Semitia/M-P-Innovative-training/图片与视频/Untitled.png

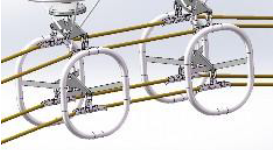
图片与视频/Untitled.png
