Semitia/M-P-Innovative-training/图片与视频/总体预览.png

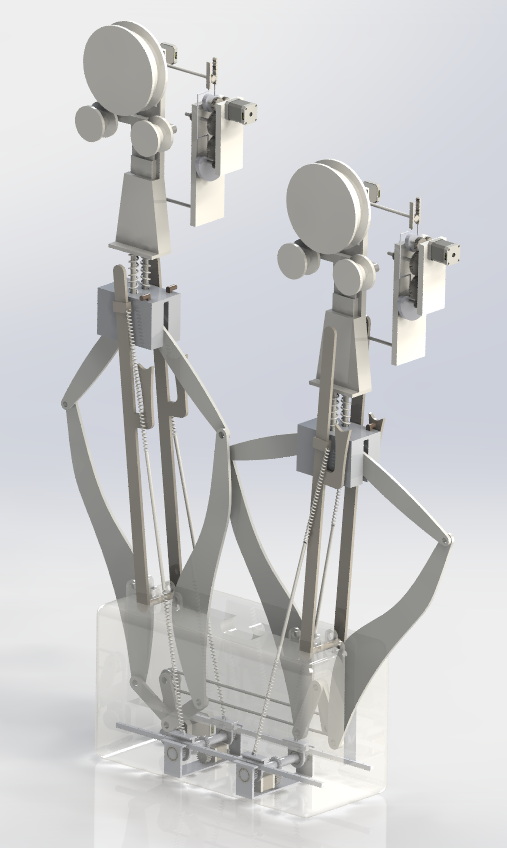
图片与视频/总体预览.png
