Semitia/M-P-Innovative-training/README.md

# M-P-Innovative-training
Innovative training in mechanical principles——机械原理创新训练课程设计
