Semitia/M-P-Innovative-training/图片与视频/Untitled 6.png

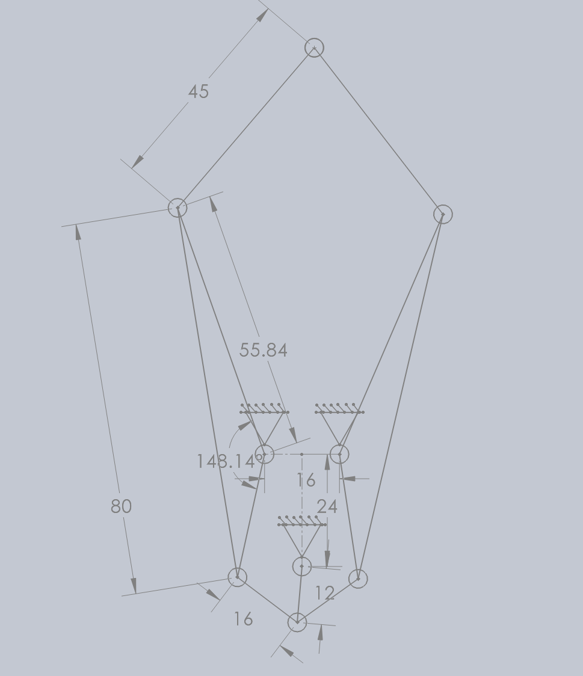
图片与视频/Untitled 6.png
