Semitia/M-P-Innovative-training/图片与视频/Untitled 24.png

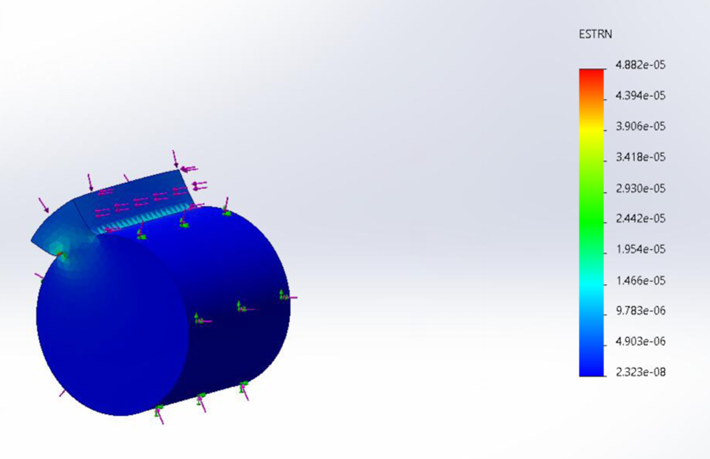
图片与视频/Untitled 24.png
