Semitia/M-P-Innovative-training/图片与视频/Untitled 32.png

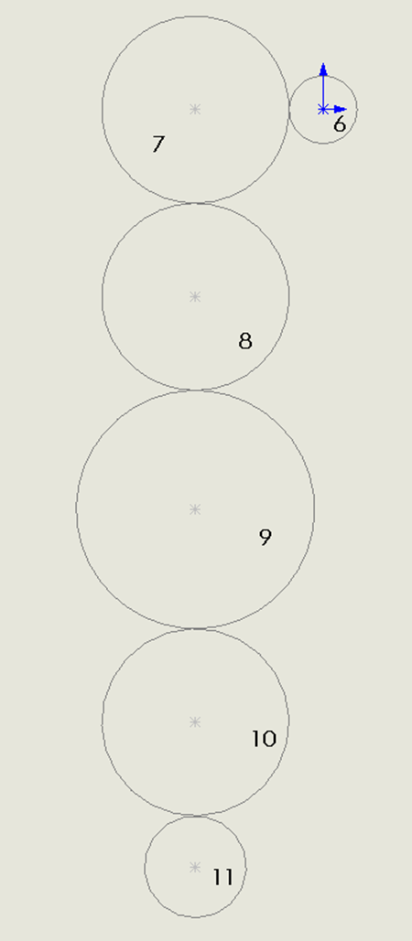
图片与视频/Untitled 32.png
