Semitia/M-P-Innovative-training/结构模型/凸轮齿轮齿条机构.SLDASM

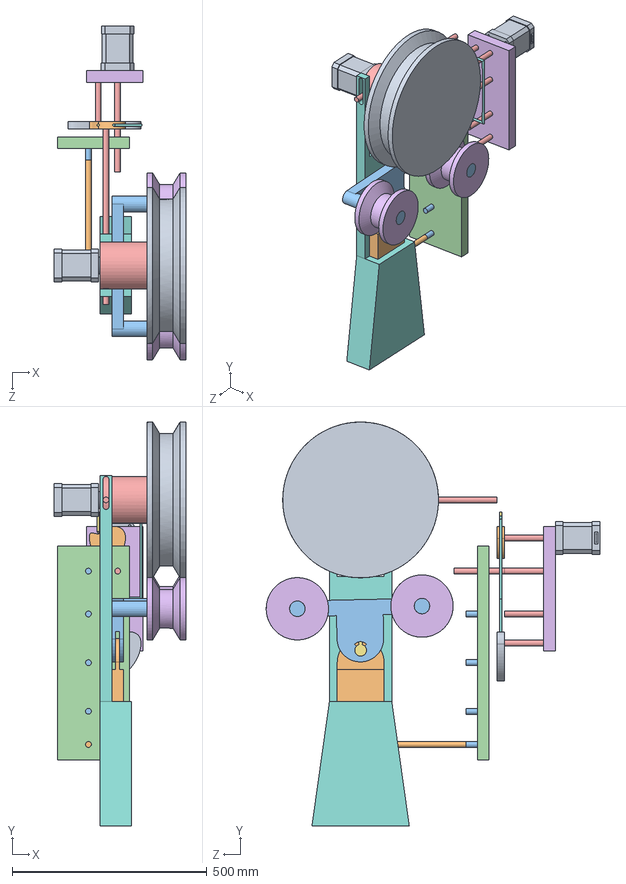
[picture p60: CAD file, 2023-04-17]
结构模型/凸轮齿轮齿条机构.SLDASM
338.0 x 1037.1 x 856.4 mm
左轮试验
右轮试验
推杆2
推杆
齿轮系底座
齿轮轴 x 6
4个弹簧
T上
T下
大轮
底座
销钉
小轮 x 2
ZHOU
齿轮系底座2
齿轮轴2 x 5
齿轮轴3
42步进电机 x 2
