Semitia/M-P-Innovative-training/结构模型/装机.SLDASM

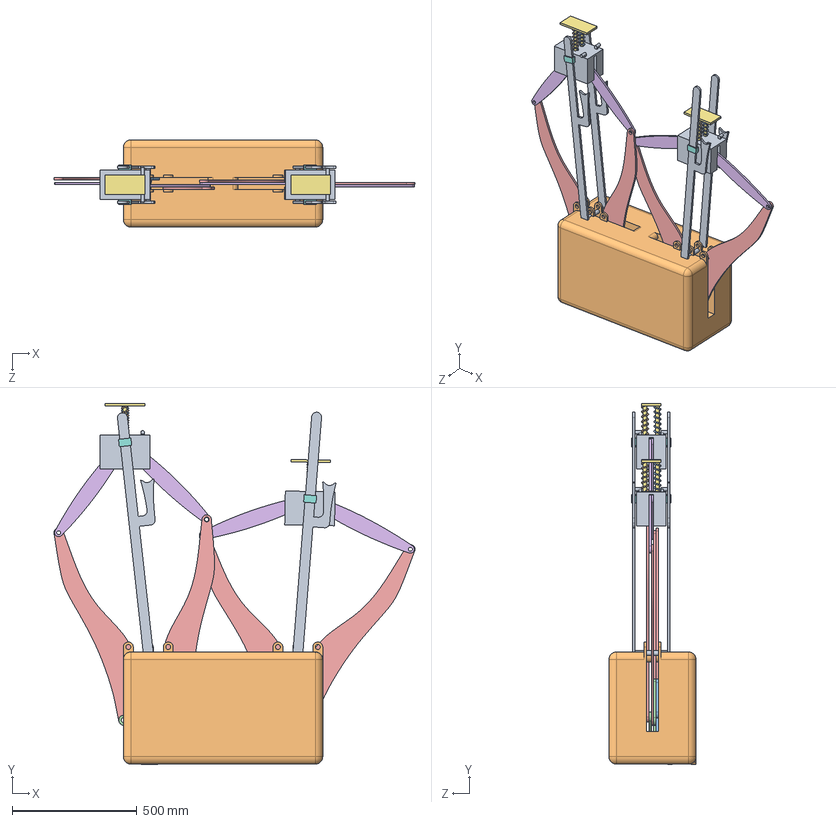
[picture p61: CAD file, 2023-04-17]
结构模型/装机.SLDASM
1448.2 x 1450.0 x 350.0 mm
机架
120mm连杆 x 2
160mm连杆(12) x 4
三角板mini x 4
450mm连杆(45)（内） x 4
升降台 x 2
脚踝 x 4
提轴 x 4
挂箱 x 2
弹簧^脚踝 x 2
弹簧2^脚踝 x 2
小弹簧^脚踝 x 2
小弹簧2^脚踝 x 2
皮带轮 x 3
皮带^装机
滑块 x 4
提杆 x 2
42步进电机
皮带2^装机
