Semitia/M-P-Innovative-training/结构模型/改版平衡机构.SLDASM

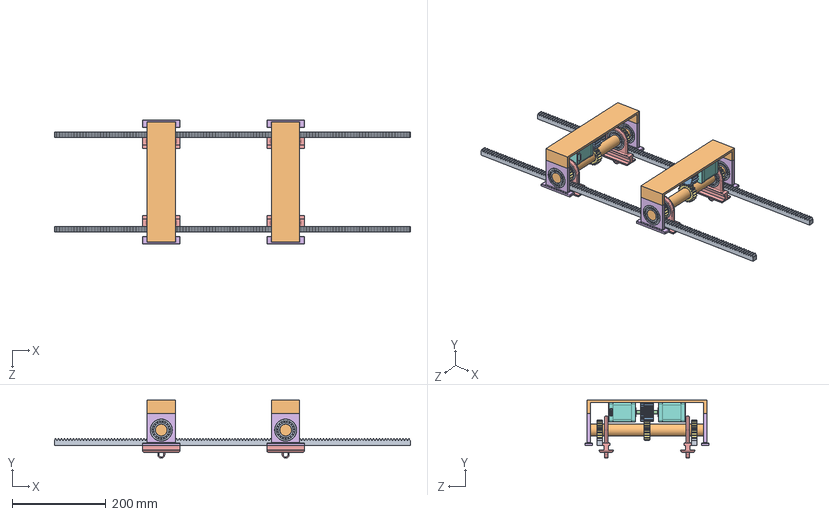
[picture p62: CAD file, 2023-04-17]
结构模型/改版平衡机构.SLDASM
760.0 x 123.5 x 265.0 mm
齿条88 x 2
轴 x 2
VNA22-2-0-18-B20-P8-V0 x 2
过度零件 x 2
轴承座2 x 4
轴承座3 x 4
圆柱齿轮20×2 x 6
42步进电机轴双出轴 x 2
deep groove ball bearings gb x 8
底板2 x 2
胖键 x 6
