Semitia/M-P-Innovative-training/结构模型/平衡加行走.SLDASM

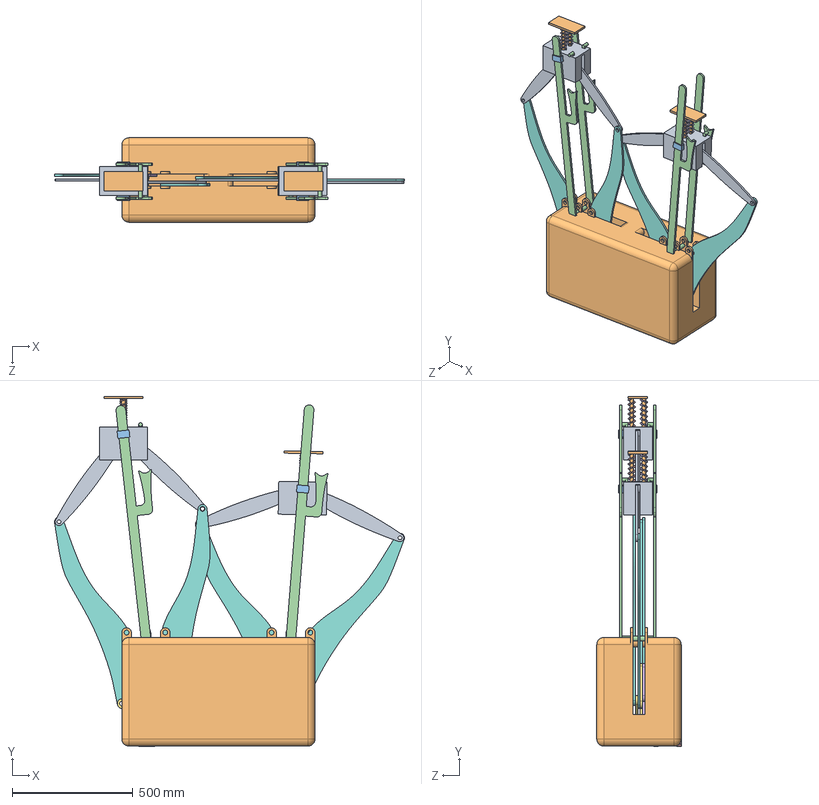
[picture p63: CAD file, 2023-04-17]
结构模型/平衡加行走.SLDASM
1448.2 x 1450.0 x 350.0 mm
齿条88 x 2
轴 x 2
VNA22-2-0-18-B20-P8-V0 x 2
过度零件 x 2
轴承座2 x 4
轴承座3 x 4
圆柱齿轮20×2 x 6
42步进电机轴双出轴 x 2
deep groove ball bearings gb x 8
底板2 x 2
胖键 x 6
机架
120mm连杆 x 2
160mm连杆(12) x 4
三角板mini x 4
450mm连杆(45)（内） x 4
升降台 x 2
脚踝 x 4
提轴 x 4
挂箱 x 2
弹簧^脚踝 x 2
弹簧2^脚踝 x 2
小弹簧^脚踝 x 2
小弹簧2^脚踝 x 2
皮带轮 x 3
皮带^装机
滑块 x 4
提杆 x 2
42步进电机
皮带2^装机
