Semitia/M-P-Innovative-training/结构模型/脚踝.SLDASM

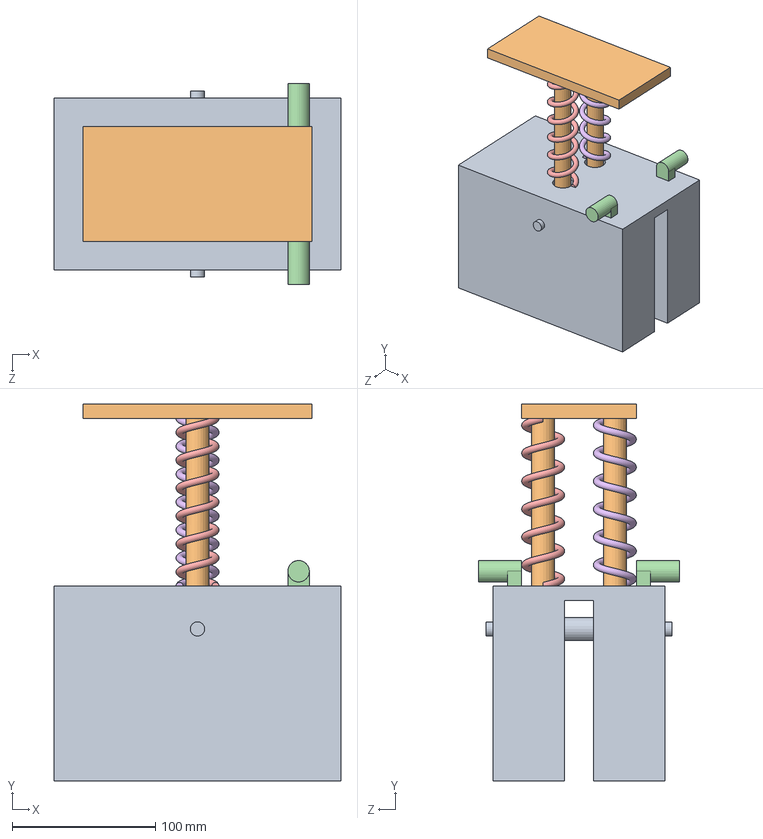
[picture p64: CAD file, 2023-04-17]
结构模型/脚踝.SLDASM
200.0 x 262.9 x 140.0 mm
升降台
脚踝 x 2
提轴 x 2
挂箱
弹簧^脚踝
弹簧2^脚踝
小弹簧^脚踝
小弹簧2^脚踝
