Semitia/M-P-Innovative-training/结构模型/滑块.SLDPRT

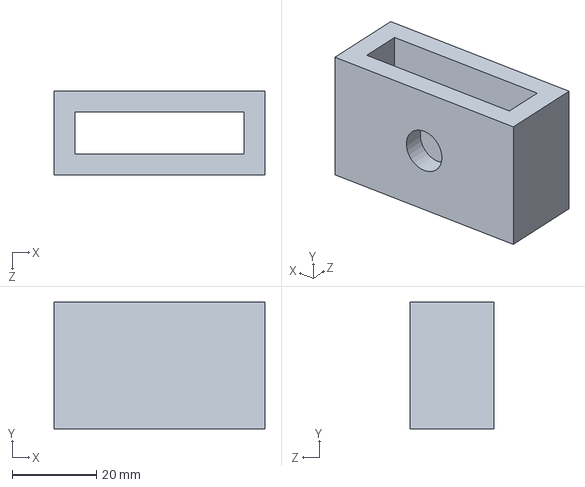
[picture p65: CAD file, 2023-04-17]
结构模型/滑块.SLDPRT
50.0 x 30.0 x 20.0 mm
