Semitia/M-P-Innovative-training/结构模型/底板2.SLDPRT

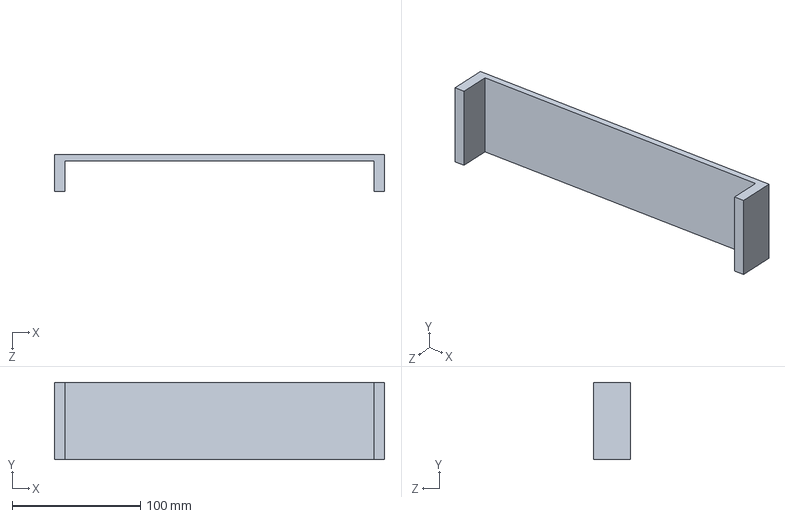
[picture p66: CAD file, 2023-04-17]
结构模型/底板2.SLDPRT
257.0 x 60.0 x 29.0 mm
