Semitia/M-P-Innovative-training/结构模型/42步进电机.SLDPRT

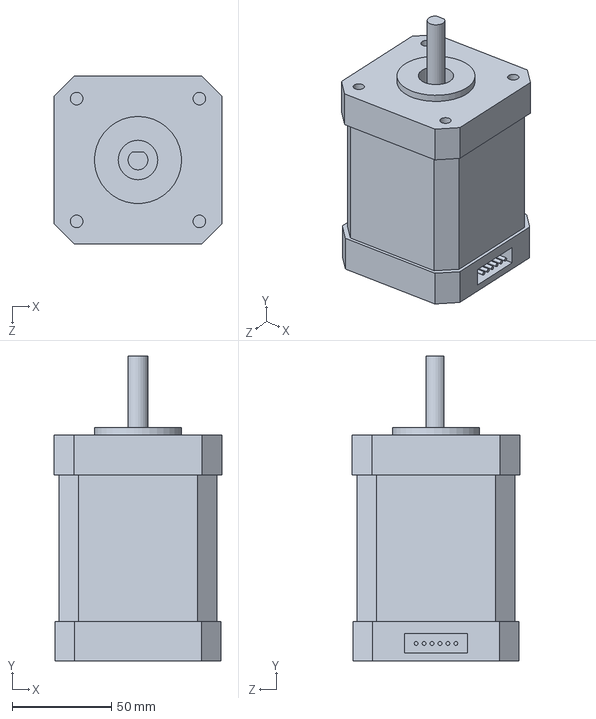
[picture p67: CAD file, 2023-04-17]
结构模型/42步进电机.SLDPRT
84.6 x 154.0 x 84.6 mm
