Semitia/M-P-Innovative-training/结构模型/圆柱齿轮20×2.SLDPRT

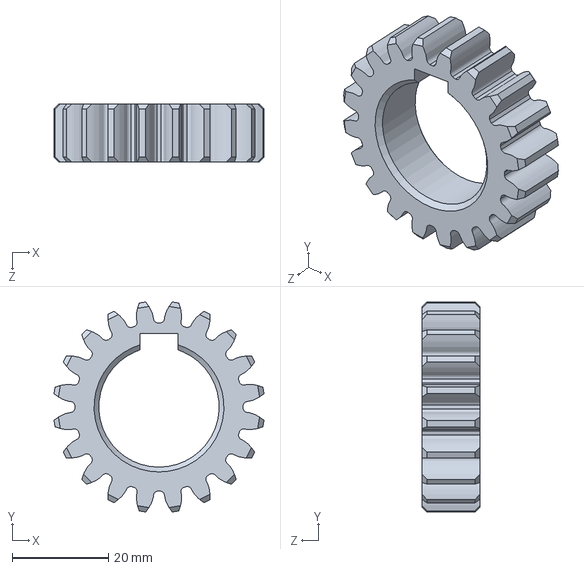
[picture p68: CAD file, 2023-04-17]
结构模型/圆柱齿轮20×2.SLDPRT
43.7 x 43.7 x 12.0 mm
