Semitia/M-P-Innovative-training/结构模型/推杆.SLDPRT

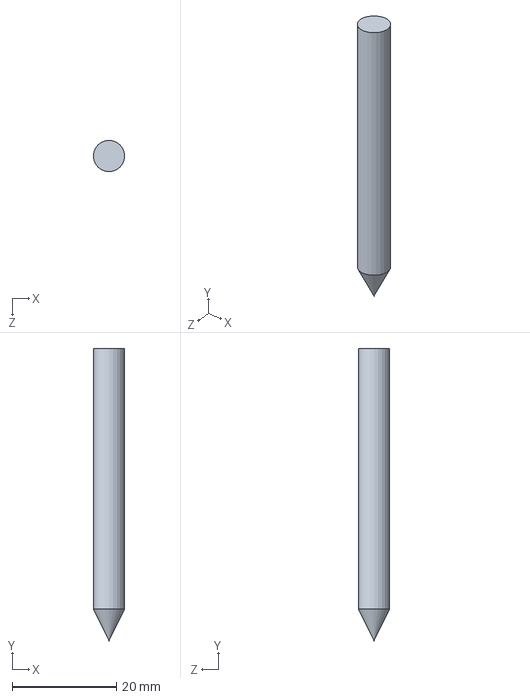
[picture p69: CAD file, 2023-04-17]
结构模型/推杆.SLDPRT
6.00 x 56.0 x 6.00 mm
