Semitia/M-P-Innovative-training/结构模型/齿轮系底座.SLDPRT

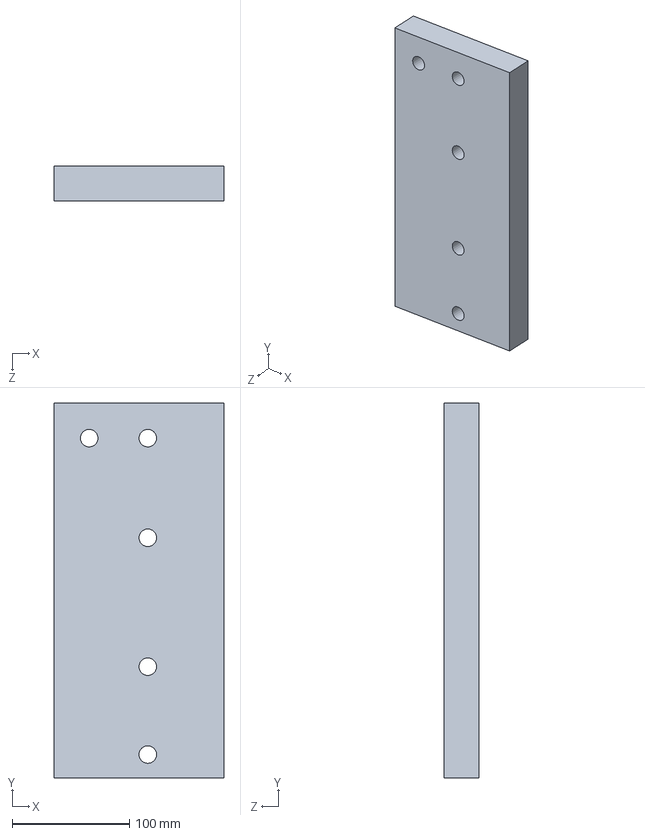
[picture p70: CAD file, 2023-04-17]
结构模型/齿轮系底座.SLDPRT
145.0 x 320.0 x 30.0 mm
