Semitia/M-P-Innovative-training/结构模型/轴承座3.SLDPRT

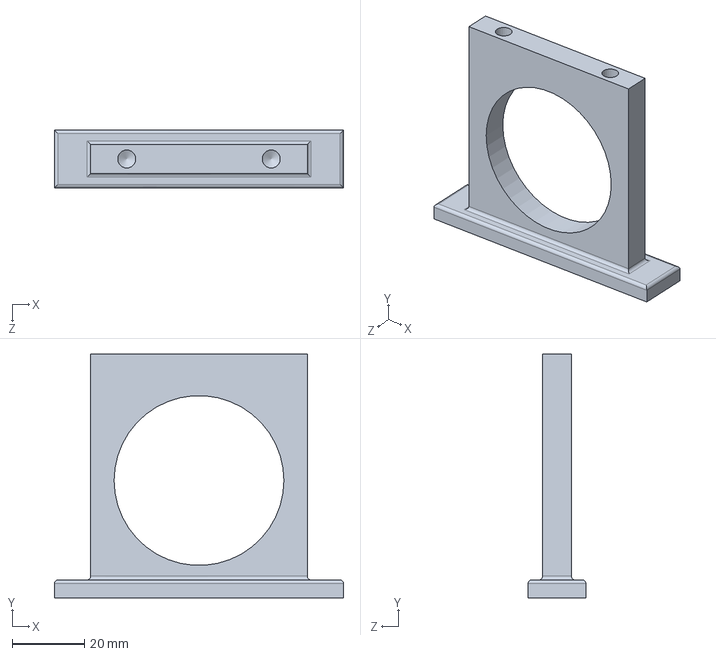
[picture p71: CAD file, 2023-04-17]
结构模型/轴承座3.SLDPRT
80.0 x 67.5 x 16.0 mm
