Semitia/M-P-Innovative-training/结构模型/三角板mini.SLDPRT

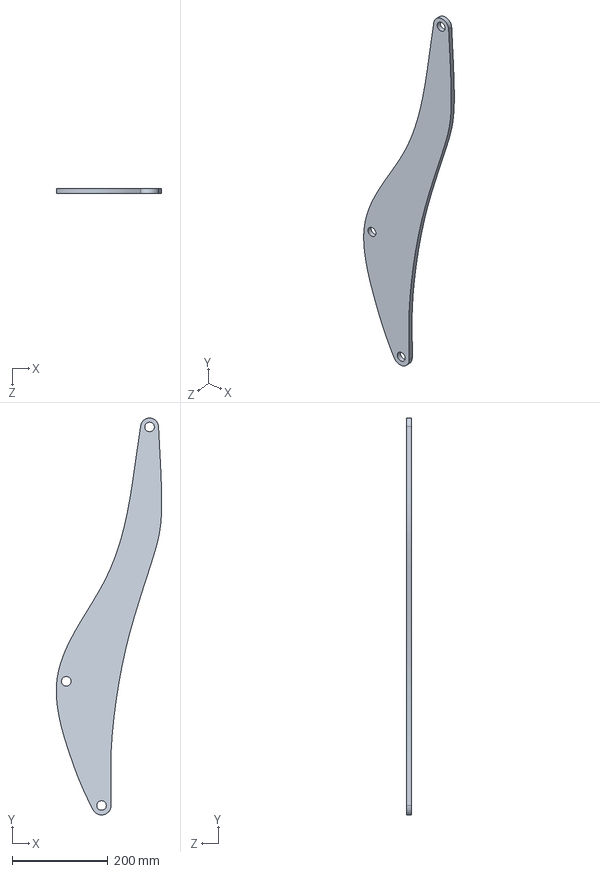
[picture p72: CAD file, 2023-04-17]
结构模型/三角板mini.SLDPRT
220.0 x 828.4 x 10.0 mm
