Semitia/M-P-Innovative-training/结构模型/T上.SLDPRT

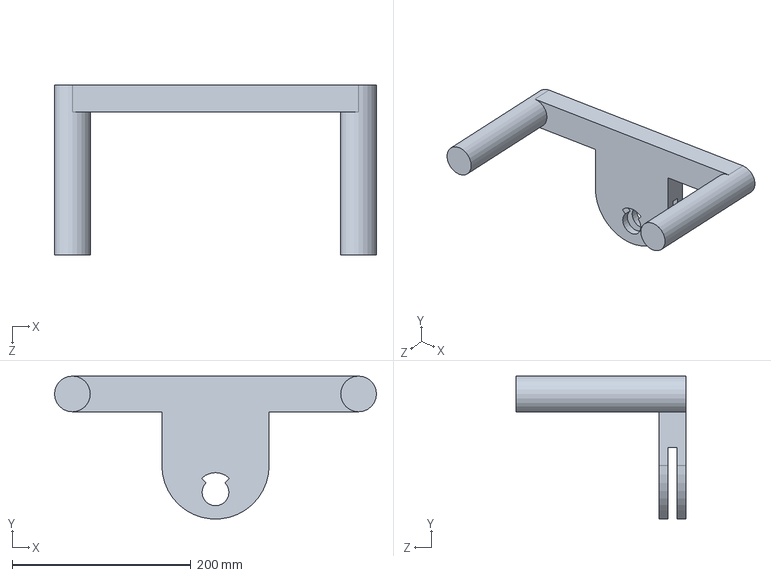
[picture p73: CAD file, 2023-04-17]
结构模型/T上.SLDPRT
360.0 x 159.8 x 190.0 mm
