Semitia/M-P-Innovative-training/结构模型/右轮试验.SLDPRT

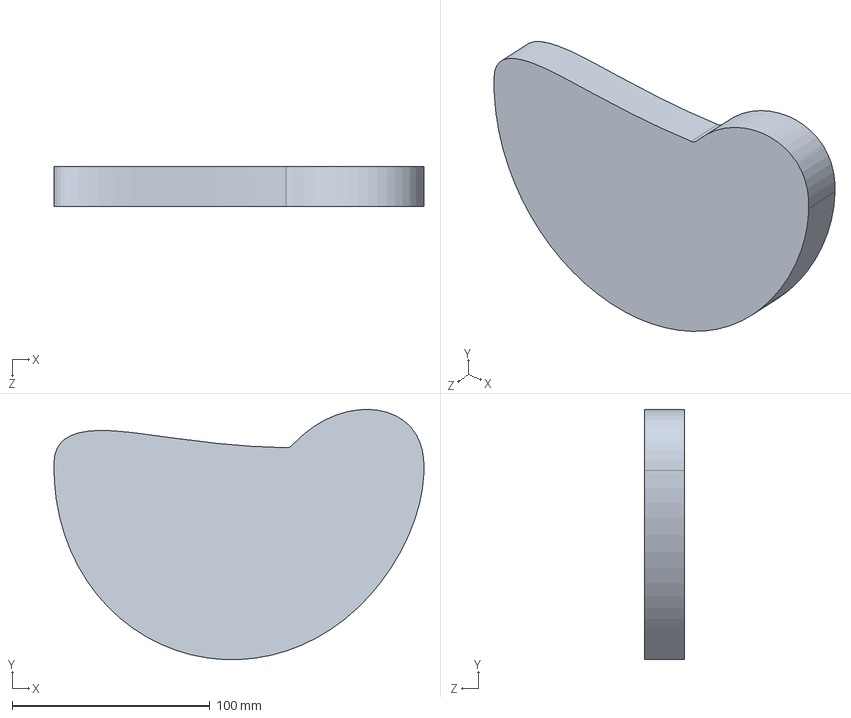
[picture p74: CAD file, 2023-04-17]
结构模型/右轮试验.SLDPRT
187.1 x 126.5 x 20.0 mm
