Semitia/M-P-Innovative-training/结构模型/42步进电机轴双出轴.SLDPRT

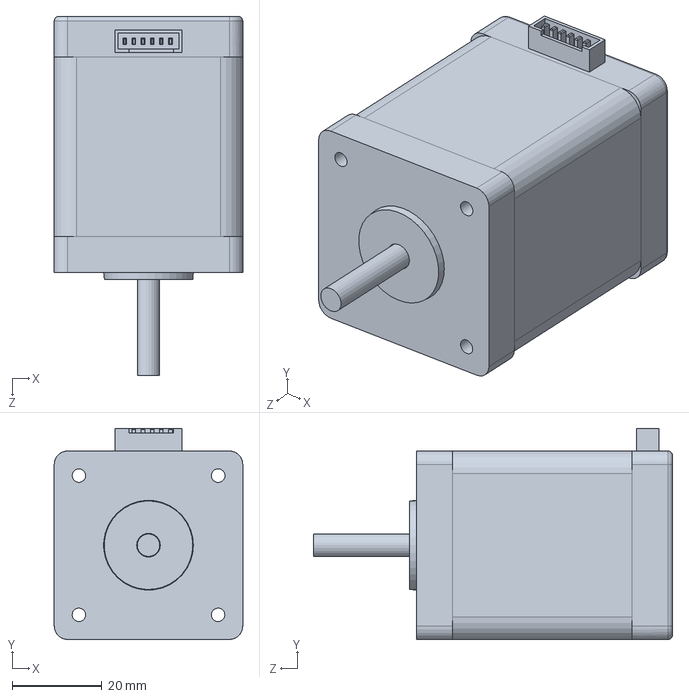
[picture p75: CAD file, 2023-04-17]
结构模型/42步进电机轴双出轴.SLDPRT
42.0 x 47.0 x 80.0 mm
