Semitia/M-P-Innovative-training/结构模型/ZHOU.SLDPRT

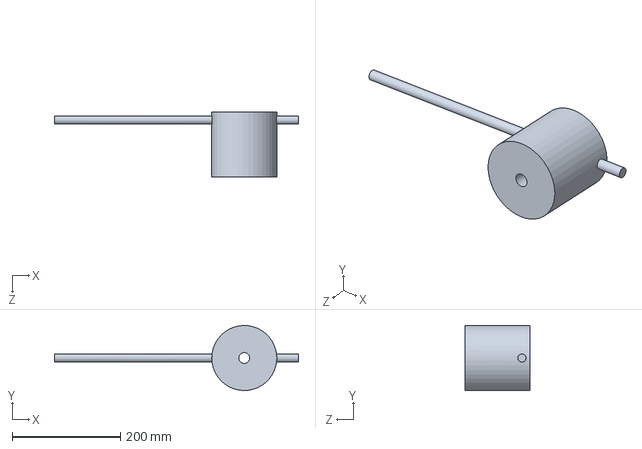
[picture p76: CAD file, 2023-04-17]
结构模型/ZHOU.SLDPRT
450.0 x 119.9 x 120.0 mm
