Semitia/M-P-Innovative-training/结构模型/左轮试验.SLDPRT

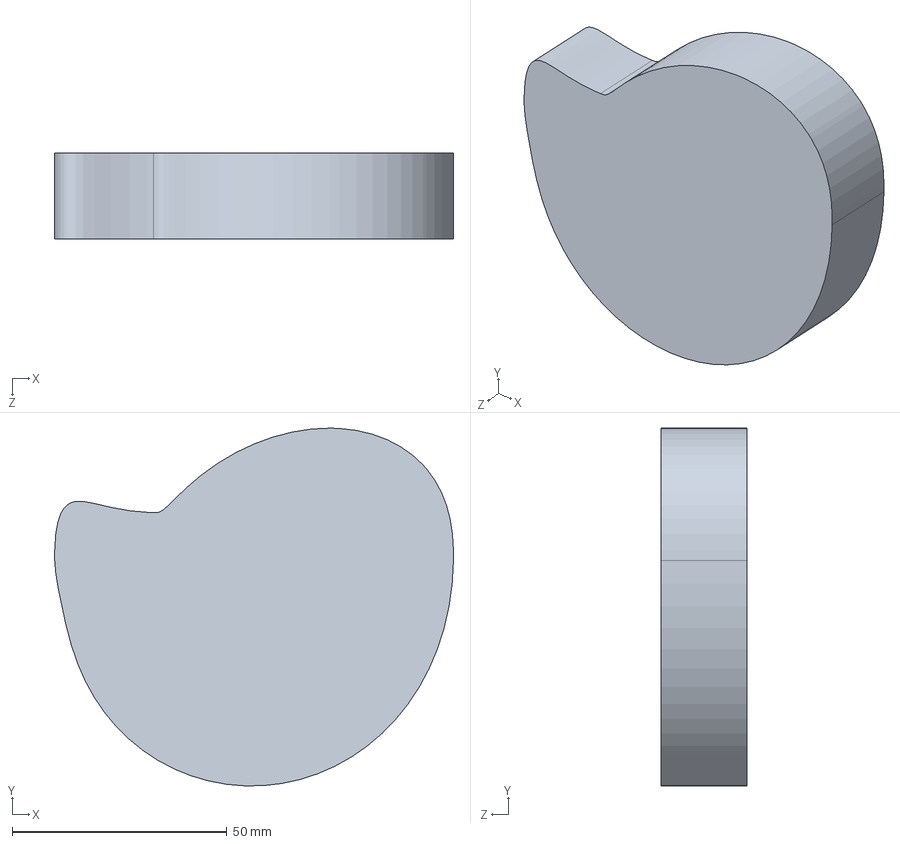
[picture p77: CAD file, 2023-04-17]
结构模型/左轮试验.SLDPRT
92.9 x 83.3 x 20.0 mm
