Semitia/M-P-Innovative-training/结构模型/机架.SLDPRT

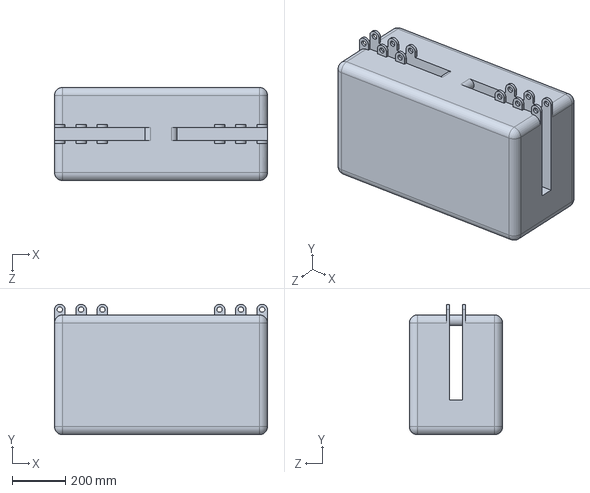
[picture p78: CAD file, 2023-04-17]
结构模型/机架.SLDPRT
800.0 x 490.0 x 350.0 mm
