Semitia/M-P-Innovative-training/结构模型/齿轮轴2.SLDPRT

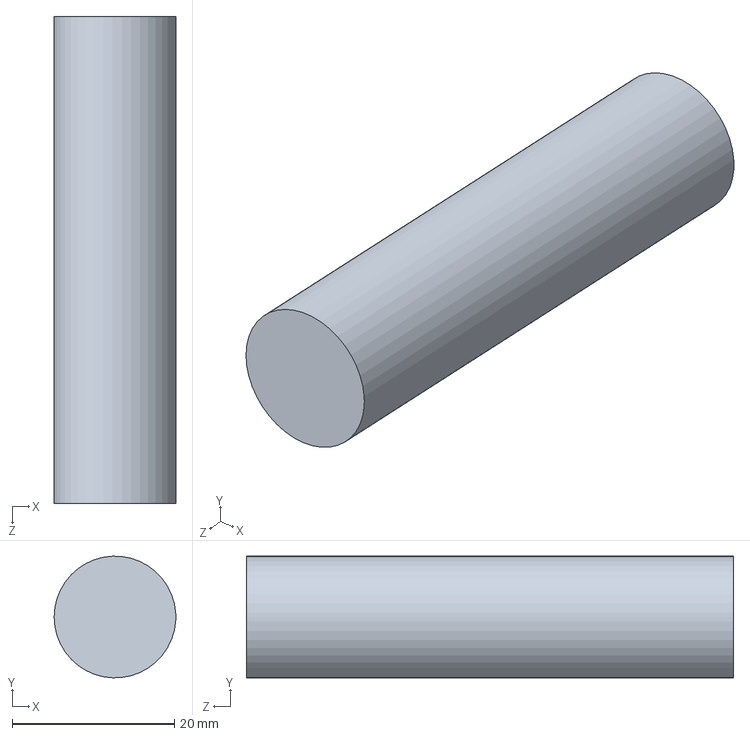
[picture p79: CAD file, 2023-04-17]
结构模型/齿轮轴2.SLDPRT
15.0 x 15.0 x 60.0 mm
