Semitia/M-P-Innovative-training/结构模型/轴.SLDPRT

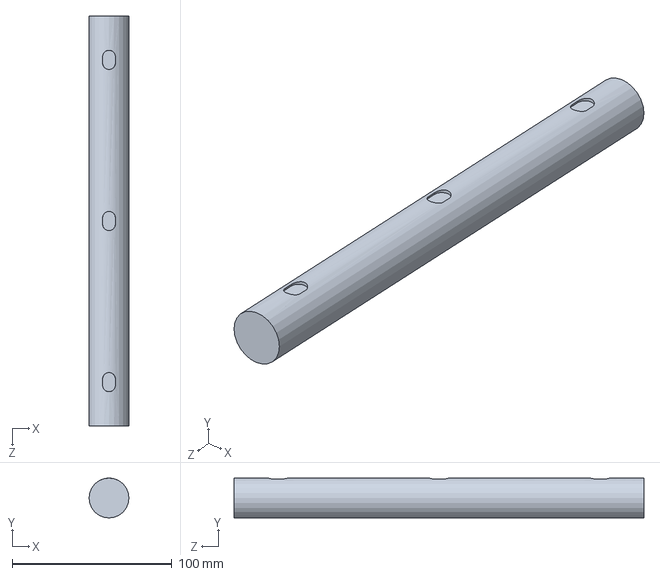
[picture p80: CAD file, 2023-04-17]
结构模型/轴.SLDPRT
25.0 x 25.0 x 257.0 mm
