Semitia/M-P-Innovative-training/结构模型/450mm连杆(45)（内）.SLDPRT

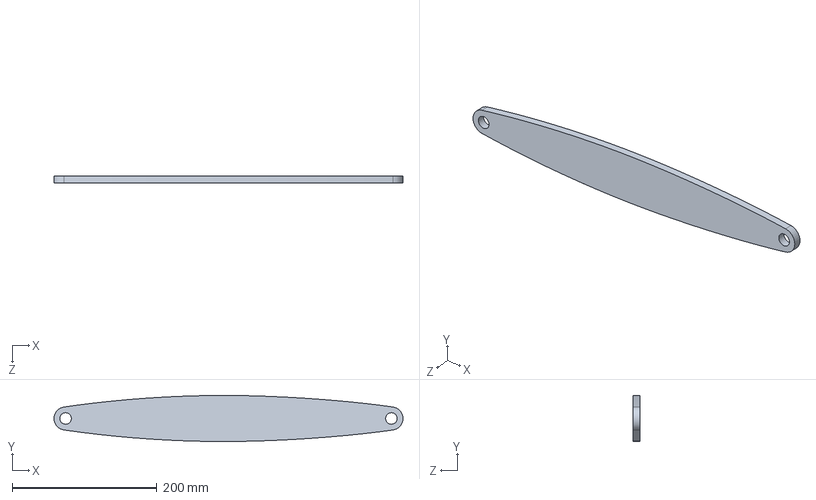
[picture p81: CAD file, 2023-04-17]
结构模型/450mm连杆(45)（内）.SLDPRT
482.0 x 63.6 x 10.0 mm
