Semitia/M-P-Innovative-training/结构模型/VNA22-2-0-18-B20-P8-V0.sldprt

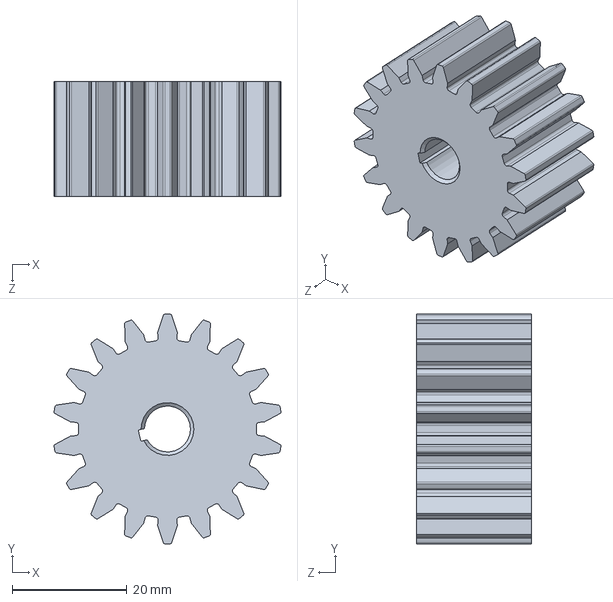
[picture p82: CAD file, 2023-04-17]
结构模型/VNA22-2-0-18-B20-P8-V0.sldprt
39.5 x 40.0 x 20.0 mm
