Semitia/M-P-Innovative-training/结构模型/胖键.SLDPRT

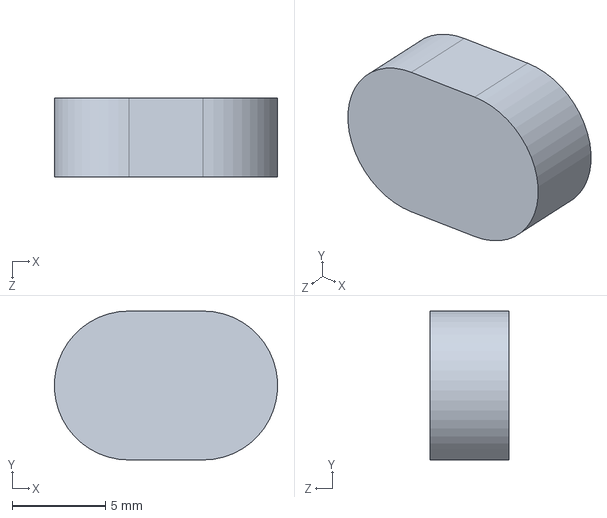
[picture p83: CAD file, 2023-04-17]
结构模型/胖键.SLDPRT
12.0 x 8.00 x 4.27 mm
