Semitia/M-P-Innovative-training/结构模型/小轮.SLDPRT

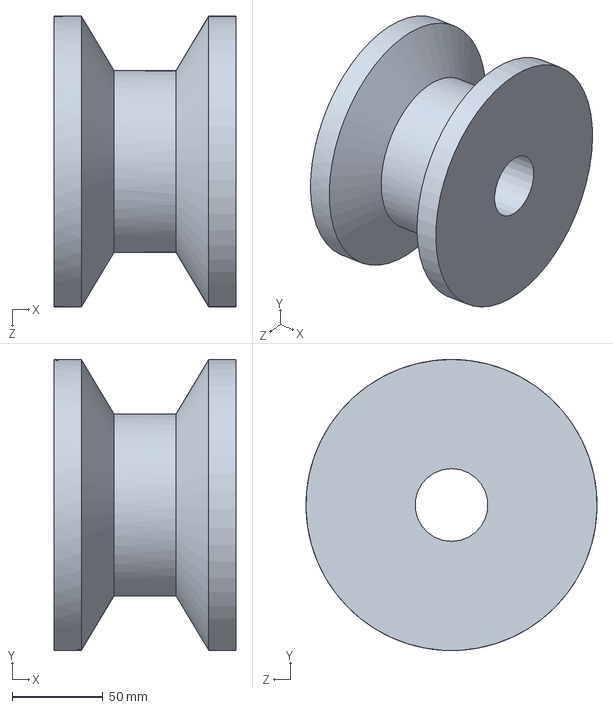
[picture p84: CAD file, 2023-04-17]
结构模型/小轮.SLDPRT
100.0 x 160.0 x 159.9 mm
