Semitia/M-P-Innovative-training/结构模型/挂箱.SLDPRT

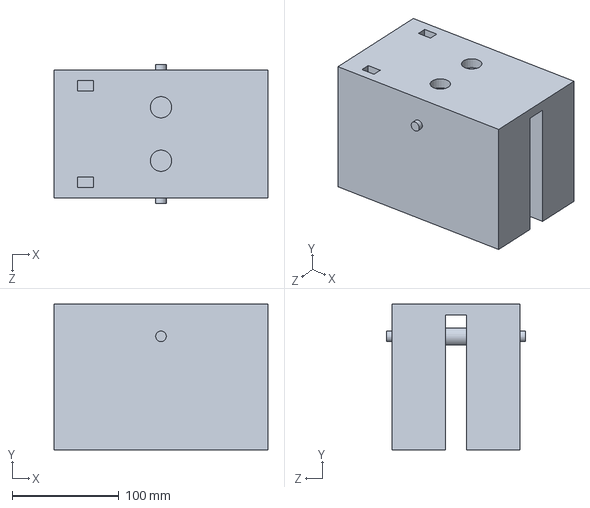
[picture p85: CAD file, 2023-04-17]
结构模型/挂箱.SLDPRT
200.0 x 136.0 x 130.0 mm
