Semitia/M-P-Innovative-training/结构模型/120mm连杆.SLDPRT

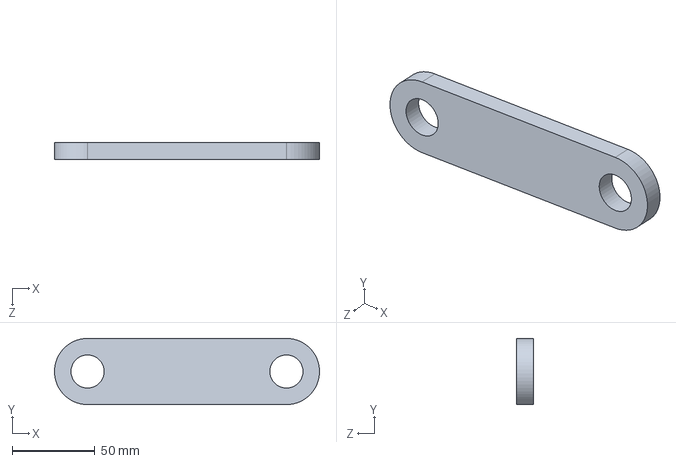
[picture p86: CAD file, 2023-04-17]
结构模型/120mm连杆.SLDPRT
159.9 x 40.0 x 10.0 mm
