Semitia/M-P-Innovative-training/结构模型/提杆.SLDPRT

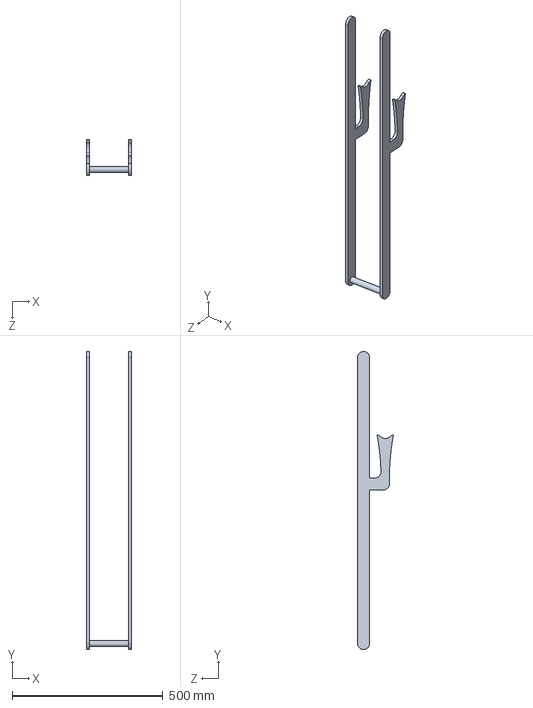
[picture p87: CAD file, 2023-04-17]
结构模型/提杆.SLDPRT
150.0 x 989.7 x 119.3 mm
