Semitia/M-P-Innovative-training/结构模型/T下.SLDPRT

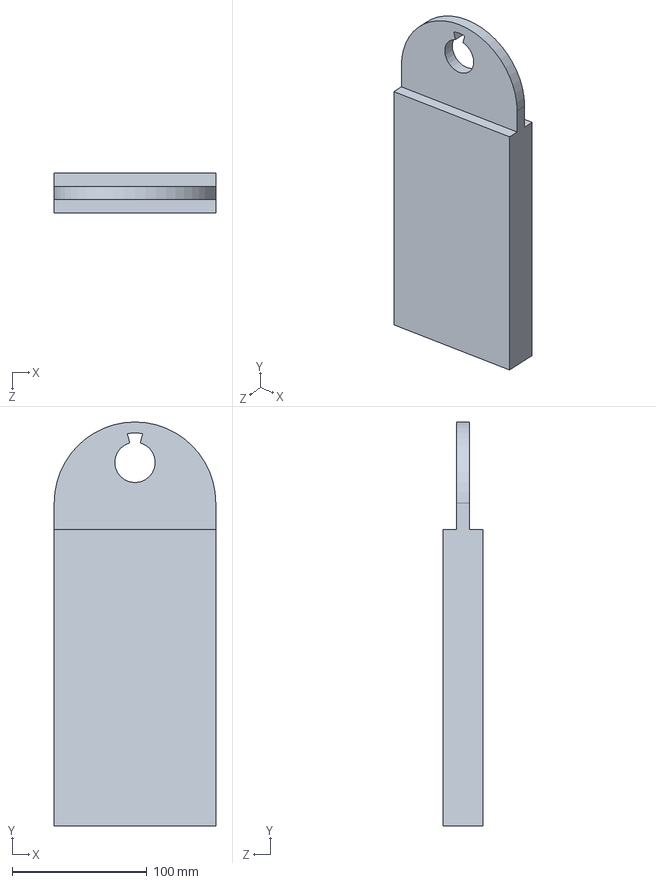
[picture p88: CAD file, 2023-04-17]
结构模型/T下.SLDPRT
120.0 x 300.0 x 30.0 mm
