Semitia/M-P-Innovative-training/结构模型/过度零件.SLDPRT

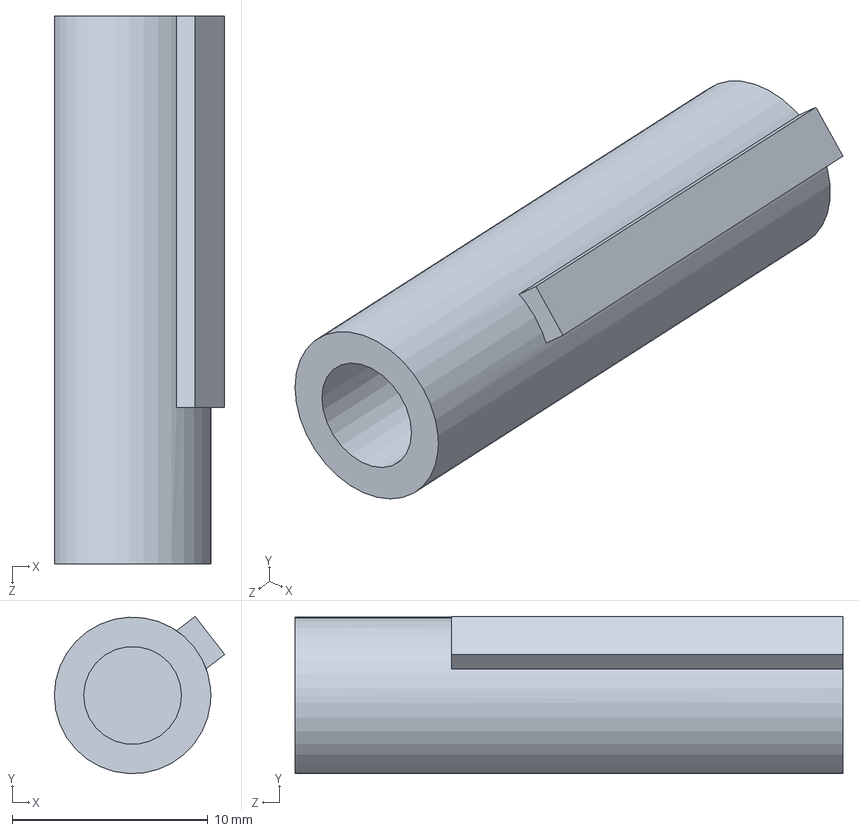
[picture p89: CAD file, 2023-04-17]
结构模型/过度零件.SLDPRT
8.71 x 8.03 x 28.0 mm
