Semitia/M-P-Innovative-training/结构模型/4个弹簧.SLDPRT

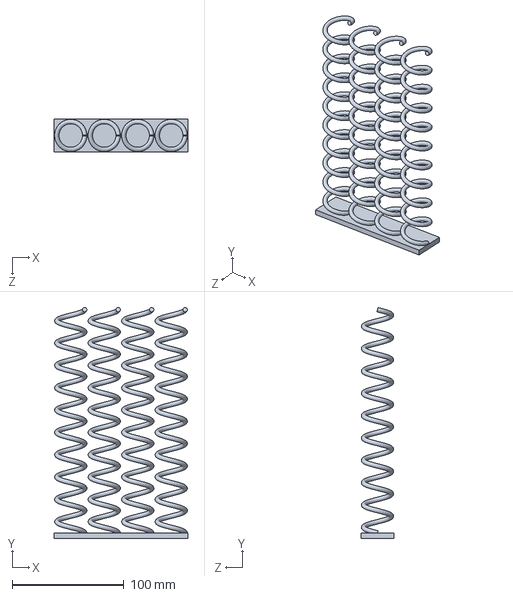
[picture p90: CAD file, 2023-04-17]
结构模型/4个弹簧.SLDPRT
120.0 x 206.9 x 30.0 mm
