Semitia/M-P-Innovative-training/结构模型/齿轮轴3.SLDPRT

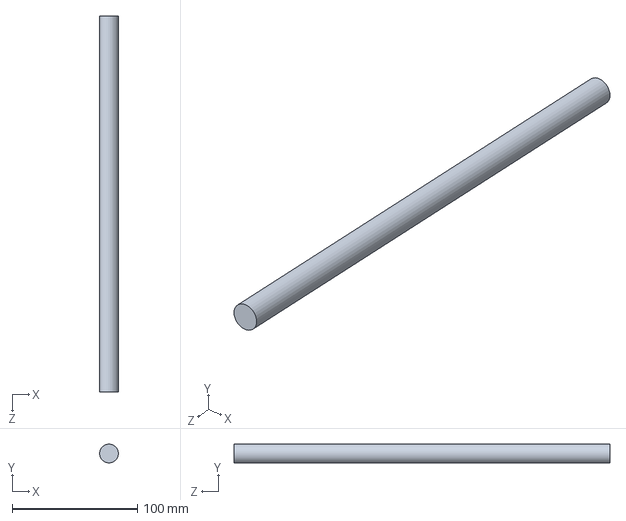
[picture p91: CAD file, 2023-04-17]
结构模型/齿轮轴3.SLDPRT
15.0 x 14.9 x 300.0 mm
