Semitia/M-P-Innovative-training/结构模型/轴承座2.SLDPRT

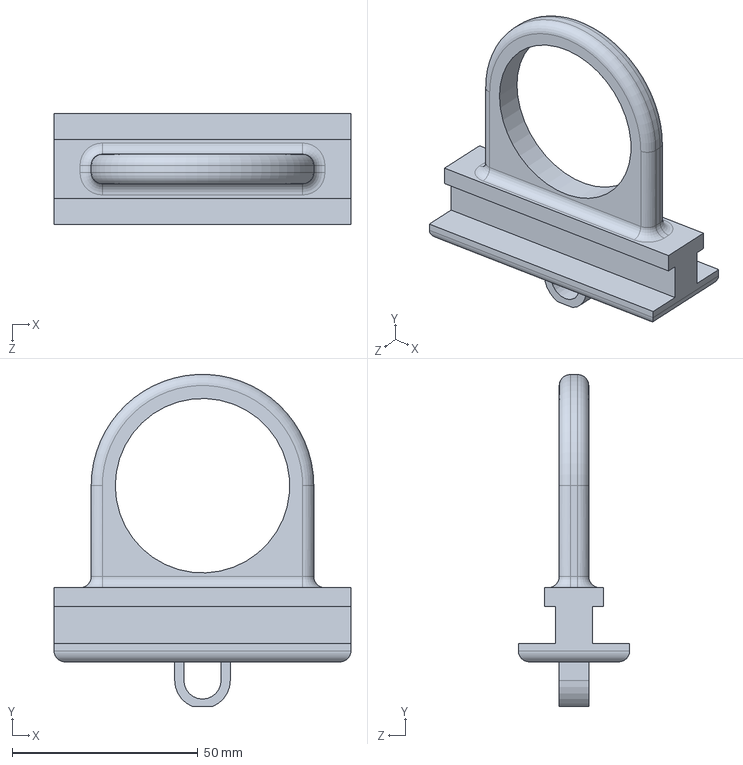
[picture p92: CAD file, 2023-04-17]
结构模型/轴承座2.SLDPRT
80.0 x 89.5 x 30.0 mm
