Semitia/M-P-Innovative-training/结构模型/升降台.SLDPRT

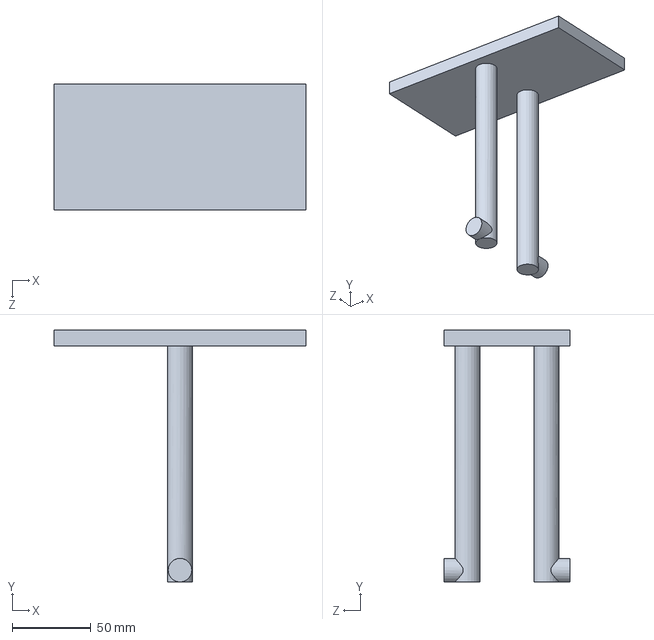
[picture p93: CAD file, 2023-04-17]
结构模型/升降台.SLDPRT
160.0 x 160.0 x 80.0 mm
