Semitia/M-P-Innovative-training/结构模型/销钉.SLDPRT

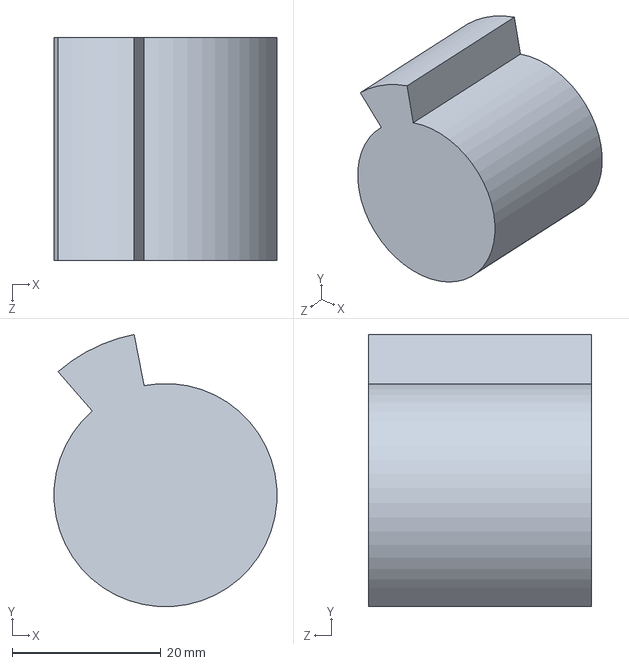
[picture p94: CAD file, 2023-04-17]
结构模型/销钉.SLDPRT
29.9 x 36.6 x 30.0 mm
