Semitia/M-P-Innovative-training/结构模型/提轴.SLDPRT

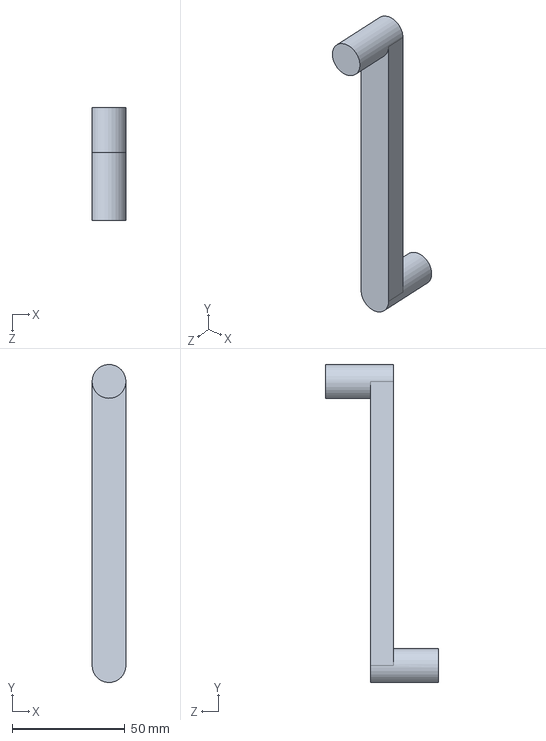
[picture p95: CAD file, 2023-04-17]
结构模型/提轴.SLDPRT
15.0 x 141.0 x 50.0 mm
