Semitia/M-P-Innovative-training/结构模型/底座.SLDPRT

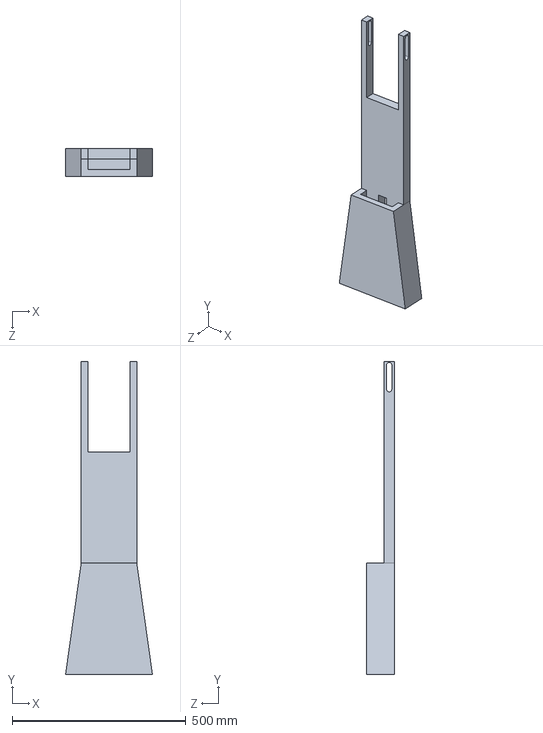
[picture p96: CAD file, 2023-04-17]
结构模型/底座.SLDPRT
250.0 x 900.0 x 80.0 mm
