Semitia/M-P-Innovative-training/结构模型/齿条88.SLDPRT

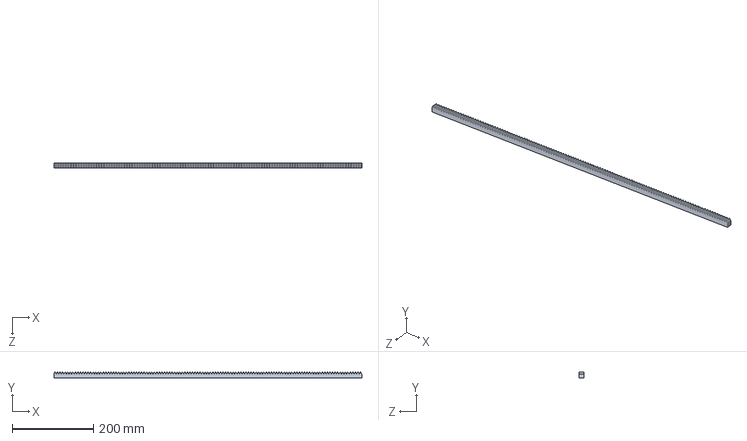
[picture p97: CAD file, 2023-04-17]
结构模型/齿条88.SLDPRT
760.0 x 14.5 x 12.0 mm
