Semitia/M-P-Innovative-training/结构模型/齿轮系底座2.SLDPRT

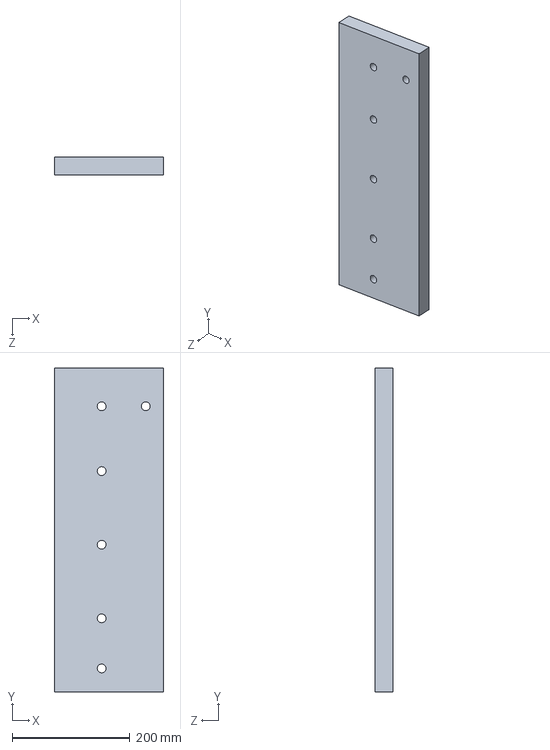
[picture p98: CAD file, 2023-04-17]
结构模型/齿轮系底座2.SLDPRT
185.0 x 550.0 x 30.0 mm
