Semitia/M-P-Innovative-training/结构模型/160mm连杆(12).SLDPRT

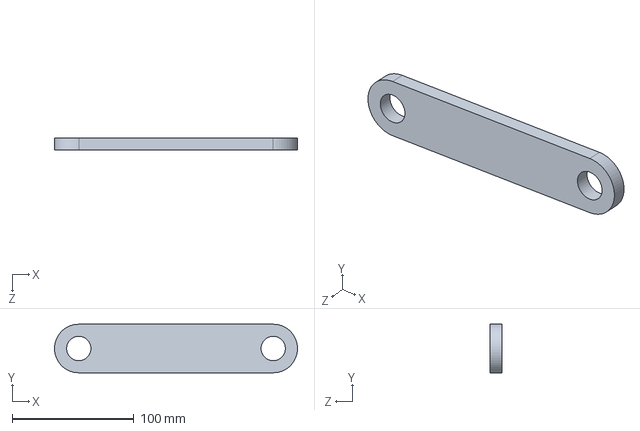
[picture p99: CAD file, 2023-04-17]
结构模型/160mm连杆(12).SLDPRT
199.9 x 40.0 x 10.0 mm
