Semitia/M-P-Innovative-training/结构模型/大轮.SLDPRT

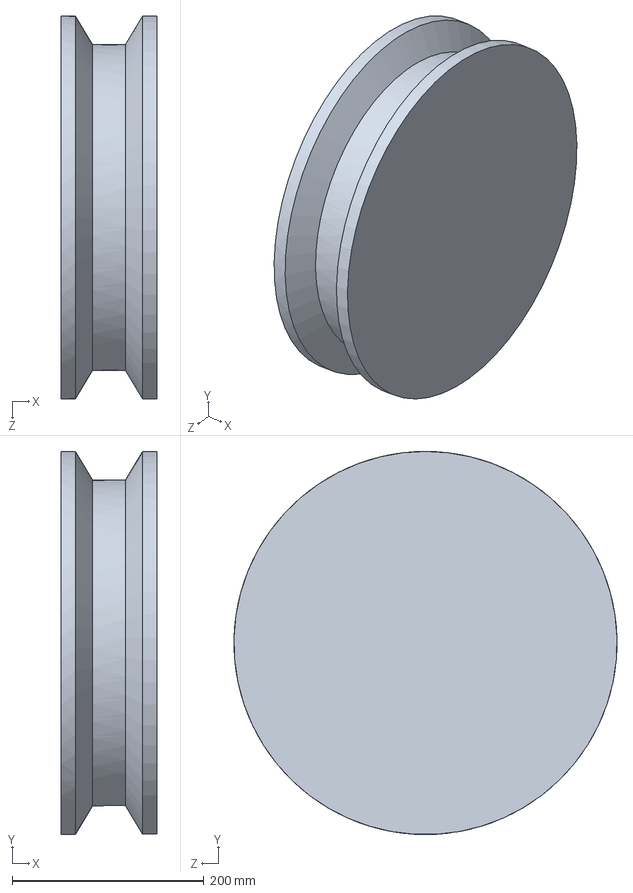
[picture p100: CAD file, 2023-04-17]
结构模型/大轮.SLDPRT
100.0 x 400.0 x 399.8 mm
