Semitia/M-P-Innovative-training/结构模型/推杆2.SLDPRT

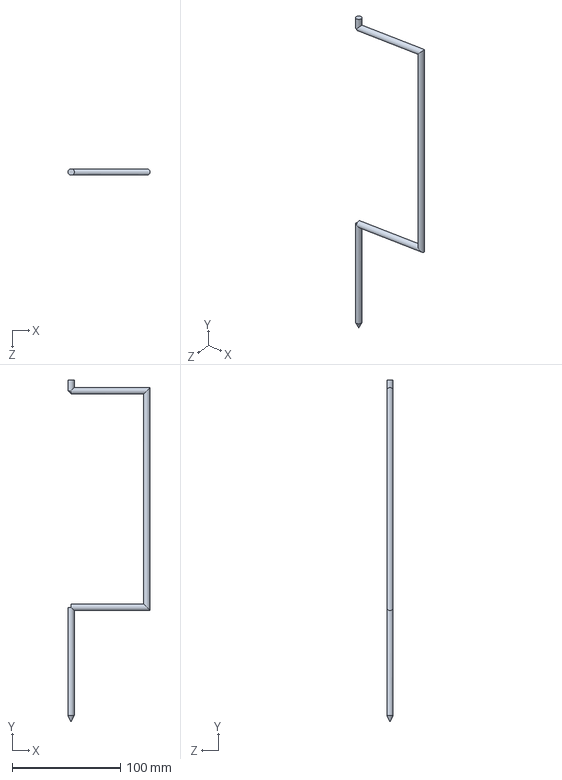
[picture p101: CAD file, 2023-04-17]
结构模型/推杆2.SLDPRT
76.0 x 316.0 x 6.00 mm
