Semitia/M-P-Innovative-training/结构模型/齿轮轴.SLDPRT

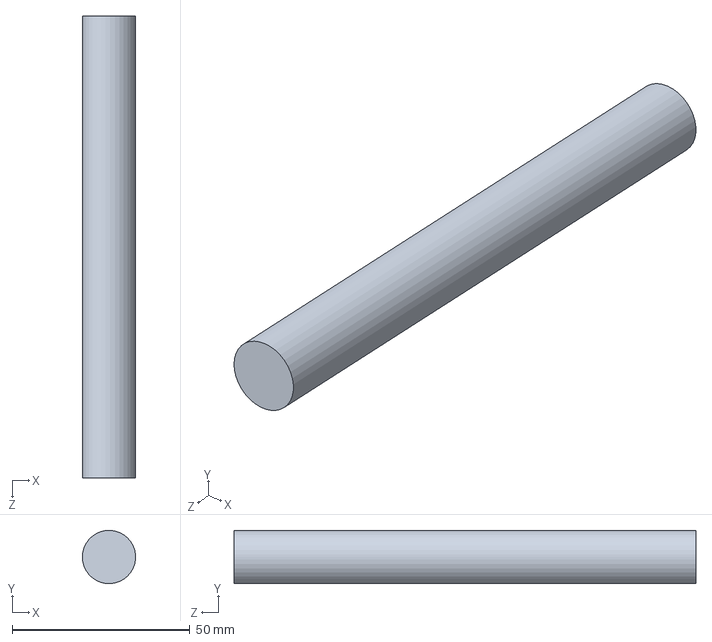
[picture p102: CAD file, 2023-04-17]
结构模型/齿轮轴.SLDPRT
15.0 x 15.0 x 130.0 mm
