Semitia/M-P-Innovative-training/结构模型/皮带轮.SLDPRT

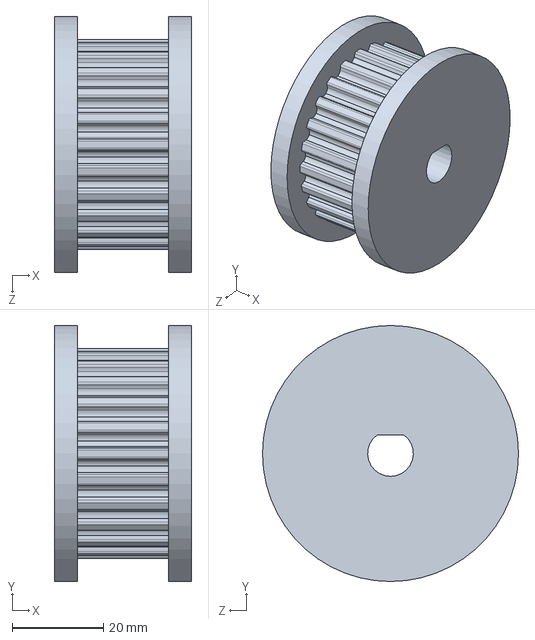
[picture p103: CAD file, 2023-04-17]
结构模型/皮带轮.SLDPRT
30.0 x 56.0 x 56.0 mm
