Semitia/M-P-Innovative-training/(list of files, cad)

Other CAD files:
结构模型/脚踝.SLDPRT
